PZero/Metronomus--Take-Your-Time/hardware/schema.md

# Schema elettrico

Schema elettrico

File: [schema.pdf](schema.pdf) (A3, vettoriale) · [schema.svg](schema.svg) · generato da [schema.py](schema.py) con `python hardware/schema.py`.

Le etichette uguali indicano piedini collegati tra loro. Gli stessi nomi di rete si usano nel piano fili.

## Reti

| Rete | Collega | Note |
|---|---|---|
| **VBAT** | TP4056 B+/OUT+ ↔ + delle due 18350 → source Q2, R8, LDO IN | Sempre presente, 3,0–4,2 V |
| **VSW** | drain Q2 → MT3608 VIN+, R1, modulo vibrazione VCC | Batteria dopo l'interruttore elettronico: spenta in letargo |
| PWR_EN | ESP32 GPIO4 → R3 10 kΩ → base Q3 2N3904 (R4 100 kΩ a GND) | Il collettore di Q3 tira giù il gate di Q2 (R8 100 kΩ verso VBAT) |
| **V12** | MT3608 VOUT+ → SimpleFOC +, Mini‑360 IN+, R6, R7 | 12,0 V |
| **3V3** | LDO OUT → ESP32 3V3 | Sempre acceso (anche in letargo) |
| **3V3_SW** | Mini‑360 OUT+ → AS5600 VCC | Spento in letargo |
| DRV_3V3 | SimpleFOC 3V3 → R9 10 kΩ → STOP | Pull‑up dell'EN, al posto del ponticello |
| STOP | SimpleFOC EN, paletti dei finecorsa, ESP32 GPIO43 | Basso = driver spento |
| ARMA | ESP32 GPIO44 → collare di ottone sul pendolo (filo flessibile) | 0 = stop attivo; 1 solo per staccarsi dal finecorsa all'avvio |
| **GND** | tutte le masse, AS5600 DIR, encoder C e SW | Comune |
| PWM_A / PWM_B / PWM_C | ESP32 GPIO7 / 6 / 5 → SimpleFOC IN1 / IN2 / IN3 | |
| SDA / SCL | ESP32 GPIO2 / 1 ↔ AS5600 SDA / SCL | I2C 400 kHz |
| ENC_A / ENC_B / ENC_SW | EC11 A / B / SW → ESP32 GPIO12 / 13 / 8 | Pull‑up interne, antirimbalzo nel firmware (niente RC, decisione del 18/10). GPIO8 risveglia dal deep sleep |
| LED_PWM | ESP32 GPIO10 → R5 470 Ω → base Q1 2N3904 (R10 100 kΩ a GND) | Corrente di base ≈ 5 mA: Q1 saturo fino a ~100 mA |
| LED_K | catodi LED1, LED2 → collettore Q1 | Emettitore di Q1 a GND |
| VIB_IN | ESP32 GPIO3 → modulo vibrazione IN | |
| VBAT_ADC | nodo R1/R2/C1 → ESP32 GPIO9 | Metà di VSW |
| M1 / M2 / M3 | SimpleFOC → fili del motore 1503 | L'ordine si aggiusta in firmware |

## Condensatori aggiuntivi (ruolo elettronica, 18/10)
- 220–470 µF tra V12 e GND direttamente ai morsetti PWR+/PWR− del driver.
- 100 nF tra 3V3_SW e GND sui pin dell'AS5600 (il Mini‑360 è uno switching).

## Da verificare sul banco
- Resistenze R6/R7 dei filamenti dopo la misura della Vf.
- Se il modulo AS5600 ha già le pull‑up su SDA/SCL (altrimenti 4,7 kΩ a 3V3).
- Modulo vibrazione: dalla foto ha già 5,1 kΩ tra base e GND, quindi niente pull‑down esterna (conferma col tester).

## Stop di emergenza
Vedi [pinout.md](pinout.md#stop-di-emergenza): paletti di rame a ±35° (STOP) e collare sul pendolo (ARMA); il contatto spegne il driver in hardware.

## Letargo (al posto dell'interruttore)
- Pressione di 3 s sul pulsante dell'encoder: il firmware ferma il pendolo, porta PWR_EN a 0 (Q2 spegne boost, driver, LED, AS5600 e vibrazione), mette SDA/SCL in alta impedenza e manda l'ESP32 in deep sleep con risveglio su GPIO8 basso.
- Al risveglio il firmware controlla che il pulsante resti premuto per 3 s; se viene lasciato prima, torna a dormire.
- Restano alimentati solo l'LDO e l'ESP32: consumo atteso di qualche decina di µA (da misurare). Togliere il LED rosso di alimentazione della SuperMini.
- Sull'ESP32‑S3 tutti i GPIO RTC (0–21) svegliano dal deep sleep: il pulsante è su GPIO8.
