PZero/Metronomus--Take-Your-Time/fili/misure-da-prendere.md

# Misure da prendere col calibro

Le posizioni dei fori dei moduli sono la base di tutto il rame: un errore di 0,5 mm su un pin si ritrova su ogni pezzo collegato. Oggi i valori in [`moduli.yaml`](moduli.yaml) sono **stimati** dalle foto; il PDF di taglio non si genera finché restano stimati.

## Come misurare
1. Metti la scheda **lato componenti in su**, orientata come scritto in `vista` per quel modulo.
2. L'origine è l'**angolo in basso a sinistra** della scheda. x verso destra, y verso l'alto.
3. Per ogni foro misura con il becco del calibro **dal bordo al bordo del foro** e aggiungi metà diametro del foro, così ottieni il centro. In alternativa infila un filo da 1 mm e misura al filo.
4. Per le file di pin a passo 2,54: misura solo il **primo** foro e controlla primo-ultimo (es. 9 pin: 20,32 mm).
5. Scrivi i numeri nella tabella qui sotto (o direttamente in `moduli.yaml`, cambiando `stato` in `misurato`).

## Tabella

| Modulo | Cosa misurare | Valore stimato (mm) | Misurato (mm) |
|---|---|---|---|
| ESP32‑S3 SuperMini | larghezza × altezza scheda | 18,00 × 23,50 (disegno Nologo; 18,00 già misurato) | |
| | **spessore del PCB** (non pubblicato) | 1,0 | |
| | primo foro fila sinistra (TX): x, y | 1,38 · 21,91 (disegno) | |
| | primo foro fila destra (5V): x, y | 16,62 · 21,91 (disegno) | |
| | sporgenza della USB‑C oltre il bordo | 1,2–2,2 (fonti divergenti) | |
| SimpleFOC Mini | ✅ dal disegno quotato: 26 × 21,5, fori Ø2 a 22 × 17,5, EN 5,08·20,2, nFT 5,08·17,66, M1 8,33·1,22, morsetti 22,75·15,52 / 22,75·10,32 | — | solo da confermare: ordine M1‑M3 e quale morsetto è + |
| MT3608 | larghezza × altezza | 36,0 × 17,0 | |
| | VIN−, VIN+, VOUT−, VOUT+: x, y | 3,0·13,0 · 3,0·4,5 · 33,2·12,1 · 33,2·4,8 | |
| | altezza del trimmer | 10,0 | |
| Mini‑360 | larghezza × altezza | 17,2 × 11,2 | |
| | IN+, IN−, OUT+, OUT−: x, y (e quale angolo è quale) | 1,3·9,9 · 1,3·1,3 · 15,9·9,9 · 15,9·1,3 | |
| AS5600 | larghezza × altezza | 23,5 × 23,3 | |
| | foro VCC: x, y · foro DIR: x, y | 4,85·14,3 · 18,2·16,6 | |
| | centro del chip: x, y | 11,6 · 11,9 | |
| TP4056 | larghezza × altezza (solo PCB) · sporgenza USB‑C | 26,1 × 17,4 · 1,8 (foto del venditore, micro‑USB) | |
| | OUT−, B−, B+, OUT+: x, y | 1,4·16,0 · 1,4·12,1 · 1,4·5,3 · 1,4·1,4 | |
| | IN−, IN+: x, y | 24,7·16,0 · 24,7·1,4 | |
| Motore 1503 | diametro campana · lunghezza base‑campana · interasse fori M2 | 19 · 15 · ? | |
| | **quanto sporge l'albero dal retro della base** (lì va il magnete Ø6 × 2,5, a 0,5–3 mm dal chip dell'AS5600) | 0 (a filo) | |
| Filo di rame | diametro reale (spesso è 0,95–1,05) | 1,00 | |

## Col tester (moduli scollegati)
- AS5600: resistenza **SDA–VCC**, **SCL–VCC** (pull‑up), **DIR–GND** (se c'è una resistenza, DIR non va collegato).
- Modulo vibrazione: resistenza **IN–GND** (atteso circa 6 kΩ: 1 kΩ + 5,1 kΩ).
- Filamento LED: tensione a 20–30 mA (Vf). Con due filamenti in serie serve circa il doppio.
