PZero/Metronomus--Take-Your-Time/fili/prove-giunti.md

# Prove di taglio e di giunto

Il circuito è fatto di **segmenti dritti saldati ad angolo retto**, senza pieghe. La precisione dipende da due cose: la lunghezza del taglio e la squadra del giunto. Questa prova si fa una volta, con lo stesso filo e gli stessi attrezzi della produzione.

## 1. Taglio a misura
- Il tronchesino lascia una punta a cuneo: per i giunti in battuta serve una **testa piana**.
- Metodo consigliato: tagliare ~0,3 mm più lungo, poi limare in squadra con una **battuta di fine corsa** (un blocchetto con foro da 1 mm e un fermo regolabile, anche inciso al laser).
- Controllo: calibro su 5 spezzoni da 50,0 mm. Obiettivo ±0,1 mm.

## 2. Giunto a L e a T
1. Raddrizza il filo in trazione e pulisci il rame (lana d'acciaio fine o alcool).
2. Pre‑stagna la testa del segmento in battuta e il punto del passante.
3. Blocca i due pezzi nella dima a 90°, con la testa appoggiata al fianco.
4. Salda con poco stagno: deve formare un piccolo raccordo, non una goccia.
5. Misura con il calibro le quote esterne del giunto e confrontale con il disegno.

## 3. Risultati

| Data | Prova | Errore medio (mm) | Note |
|---|---|---|---|
| — | taglio 50 mm | — | da fare |
| — | giunto a L | — | da fare |
| — | giunto a T | — | da fare |

Lo scostamento medio misurato al punto 2 diventa la correzione da applicare in `fili/geometria.yaml`.
