PZero/Metronomus--Take-Your-Time/foto/boost-mt3608.jpg

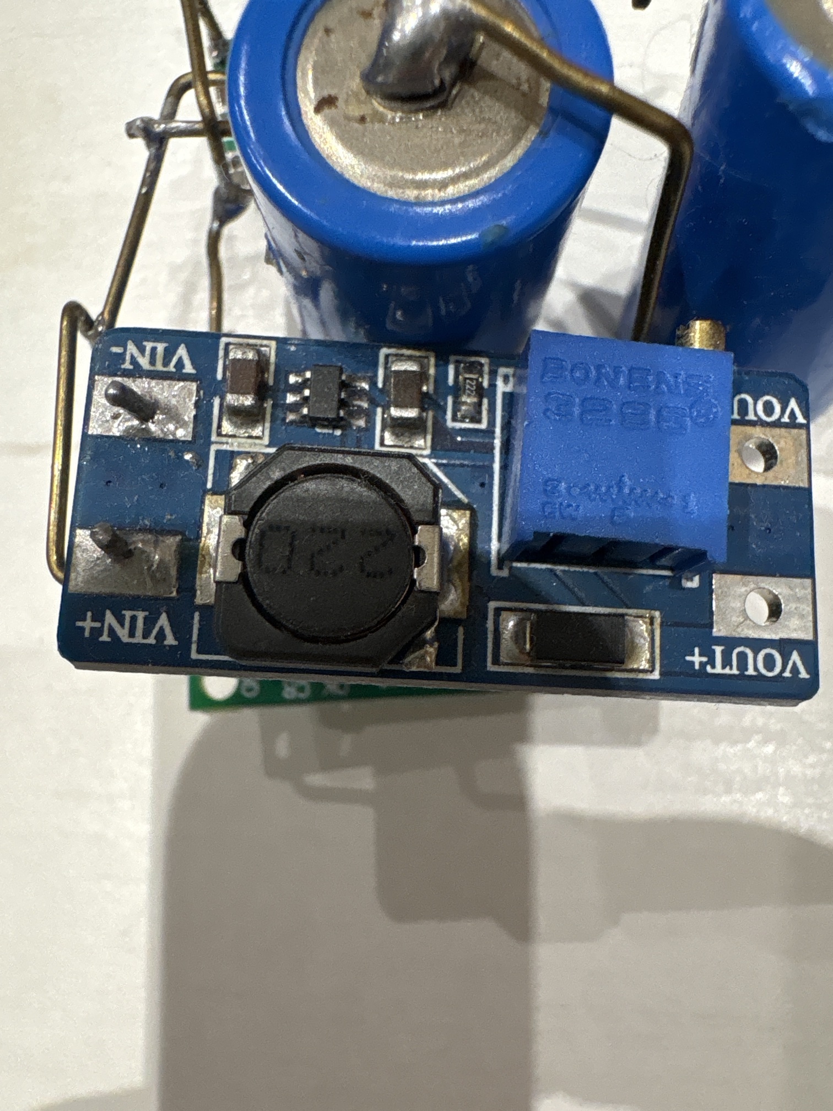
foto/boost-mt3608.jpg
