PZero/Metronomus--Take-Your-Time/foto/caricatore-tp4056-usbc.jpg

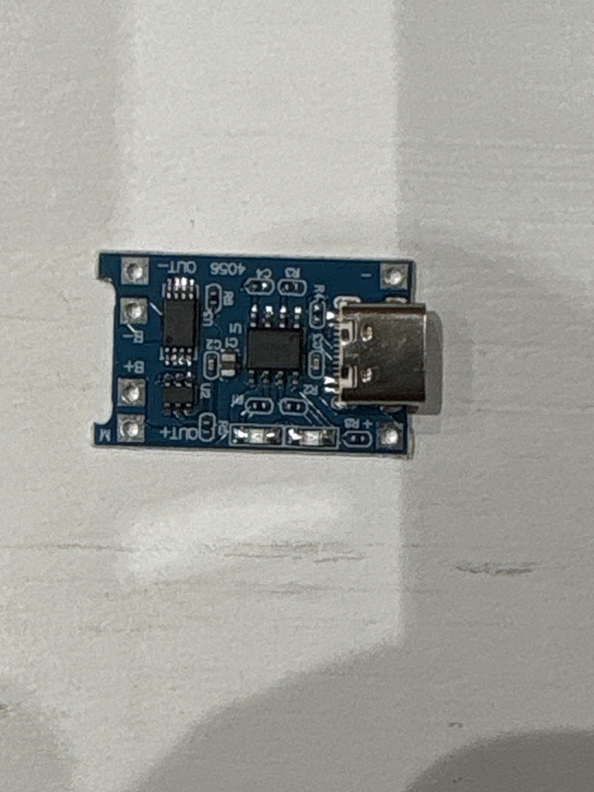
foto/caricatore-tp4056-usbc.jpg
