PZero/Metronomus--Take-Your-Time/foto/driver-simplefoc-mini.jpg

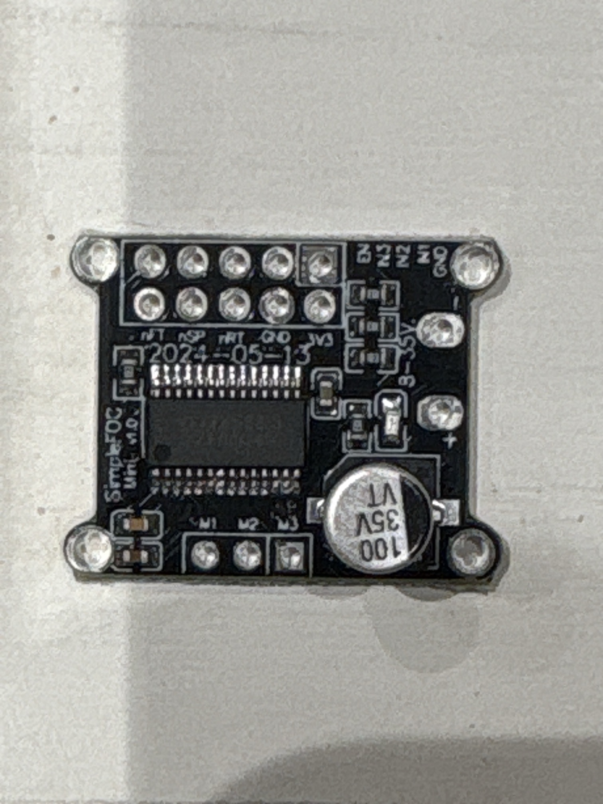
foto/driver-simplefoc-mini.jpg
