PZero/Metronomus--Take-Your-Time/foto/encoder-ec11.jpg

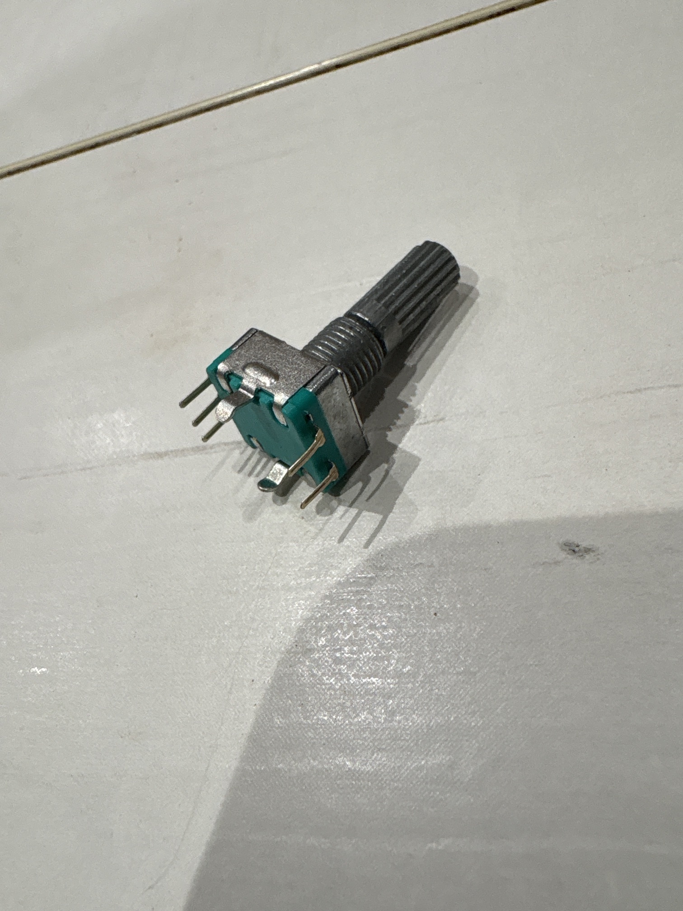
foto/encoder-ec11.jpg
