PZero/Metronomus--Take-Your-Time/foto/esp32-d1-mini-wroom.jpg

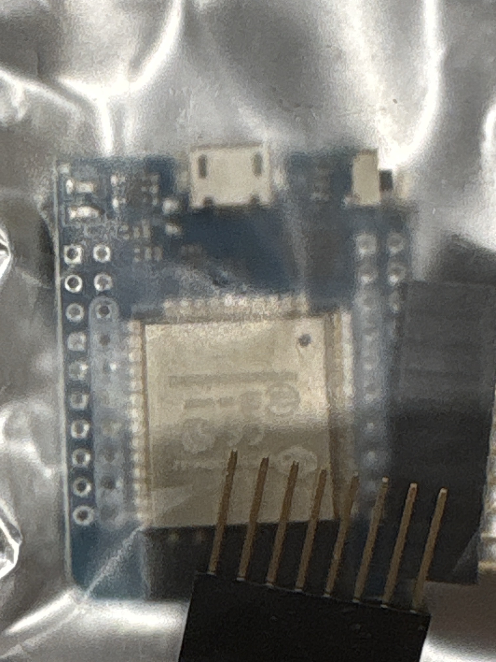
foto/esp32-d1-mini-wroom.jpg
