PZero/Metronomus--Take-Your-Time/foto/esp32-s3-supermini.jpg

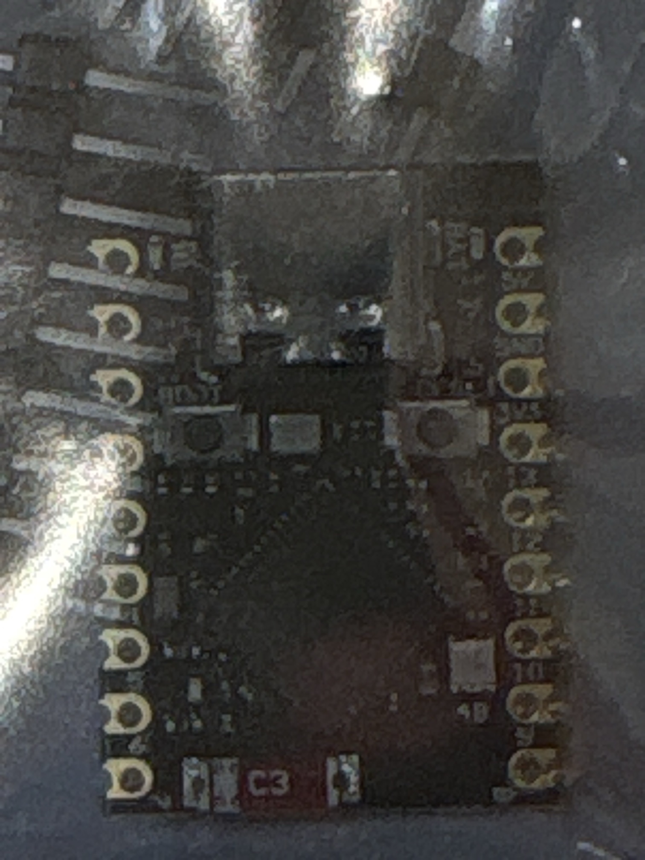
foto/esp32-s3-supermini.jpg
