PZero/Metronomus--Take-Your-Time/foto/led-filamento-prova.jpg

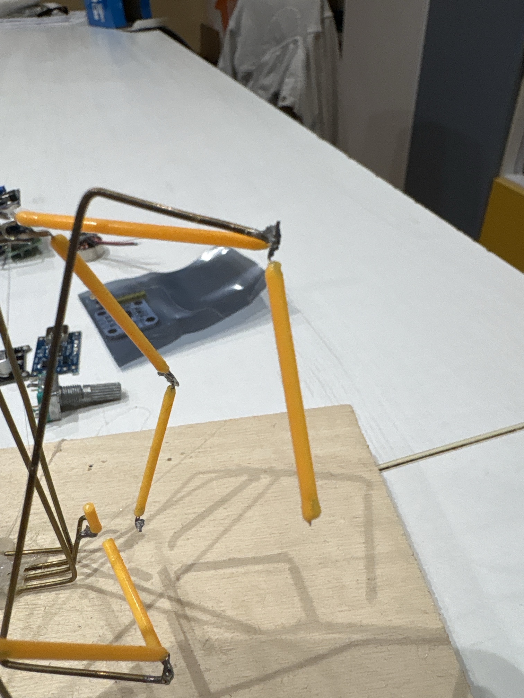
foto/led-filamento-prova.jpg
