PZero/Metronomus--Take-Your-Time/foto/motore-1503.jpg

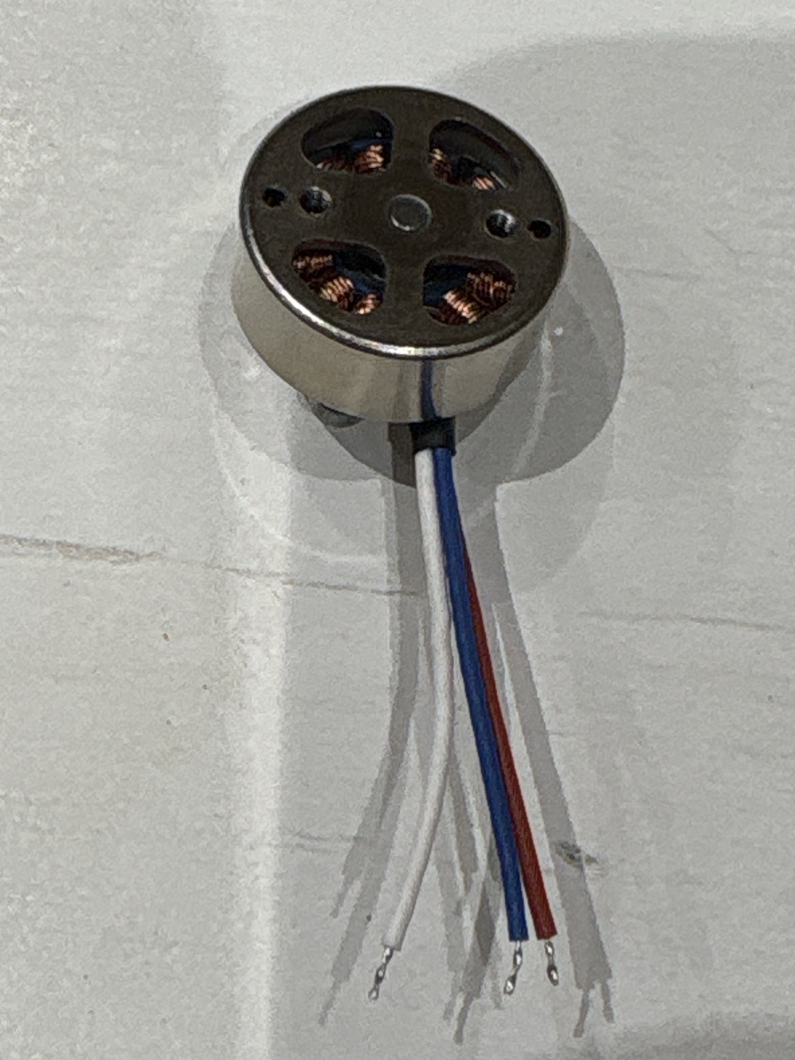
foto/motore-1503.jpg
