PZero/Metronomus--Take-Your-Time/foto/sensore-as5600.jpg

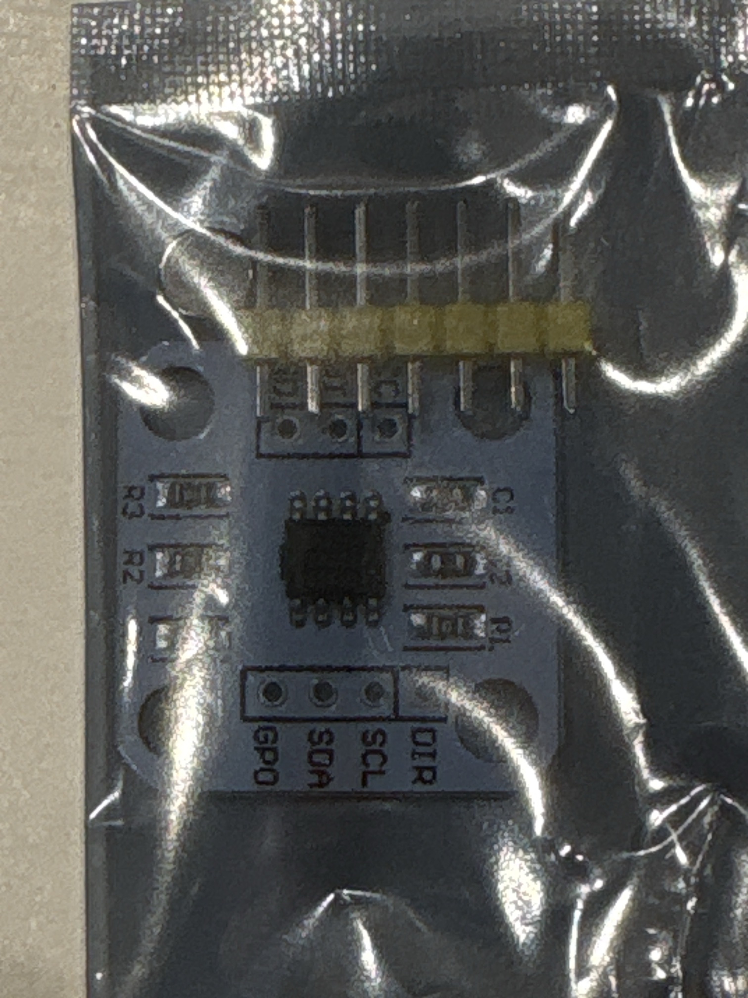
foto/sensore-as5600.jpg
