PZero/Metronomus--Take-Your-Time/foto/stepdown-mini360.jpg

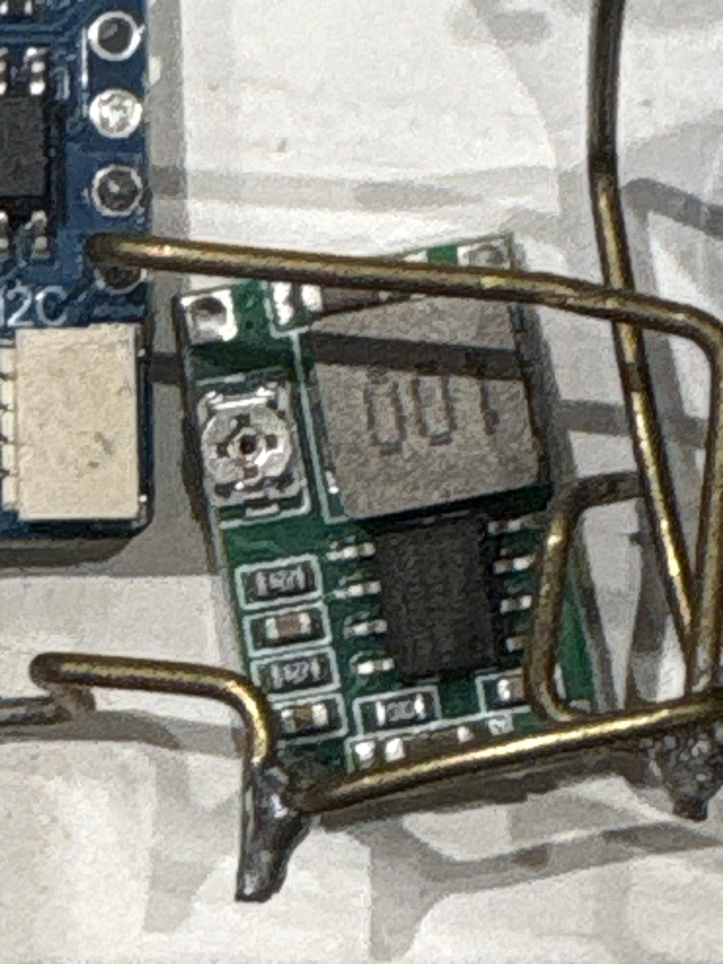
foto/stepdown-mini360.jpg
