PZero/Metronomus--Take-Your-Time/modello/anteprima.png

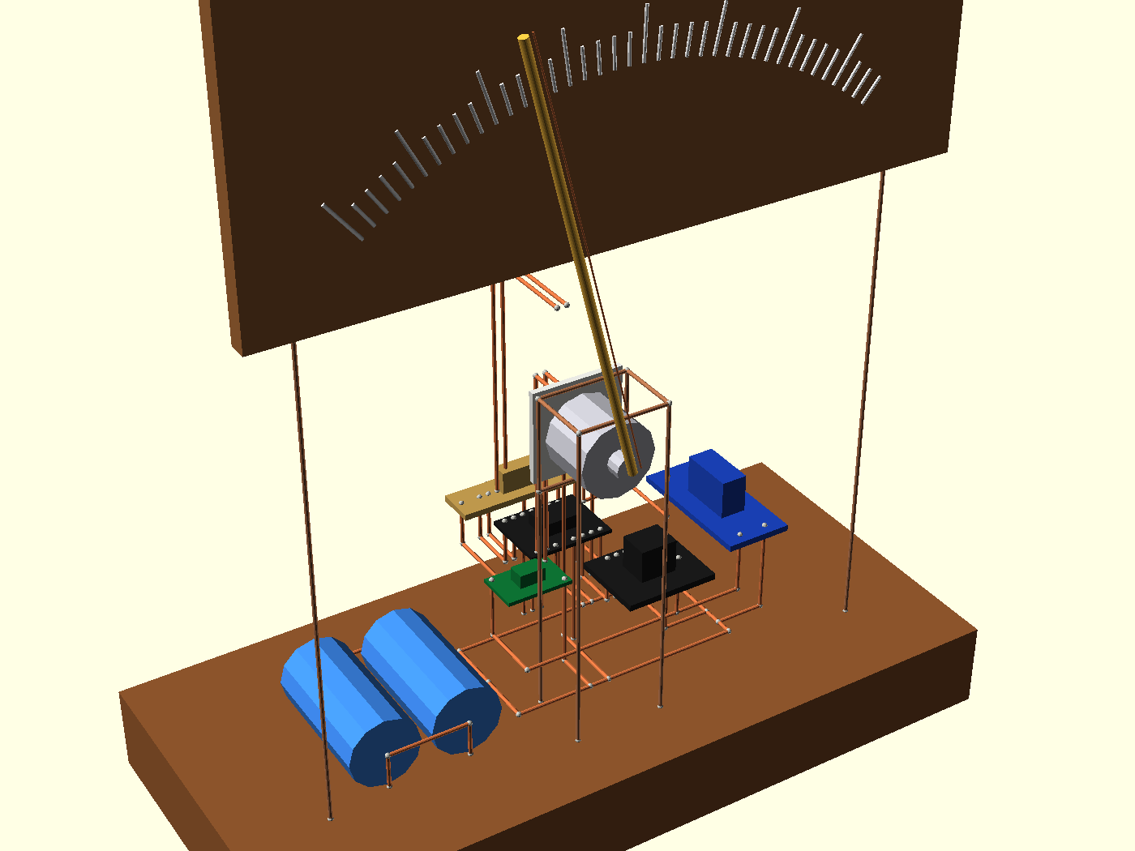
modello/anteprima.png
