PZero/Metronomus--Take-Your-Time/modello/criticita.png

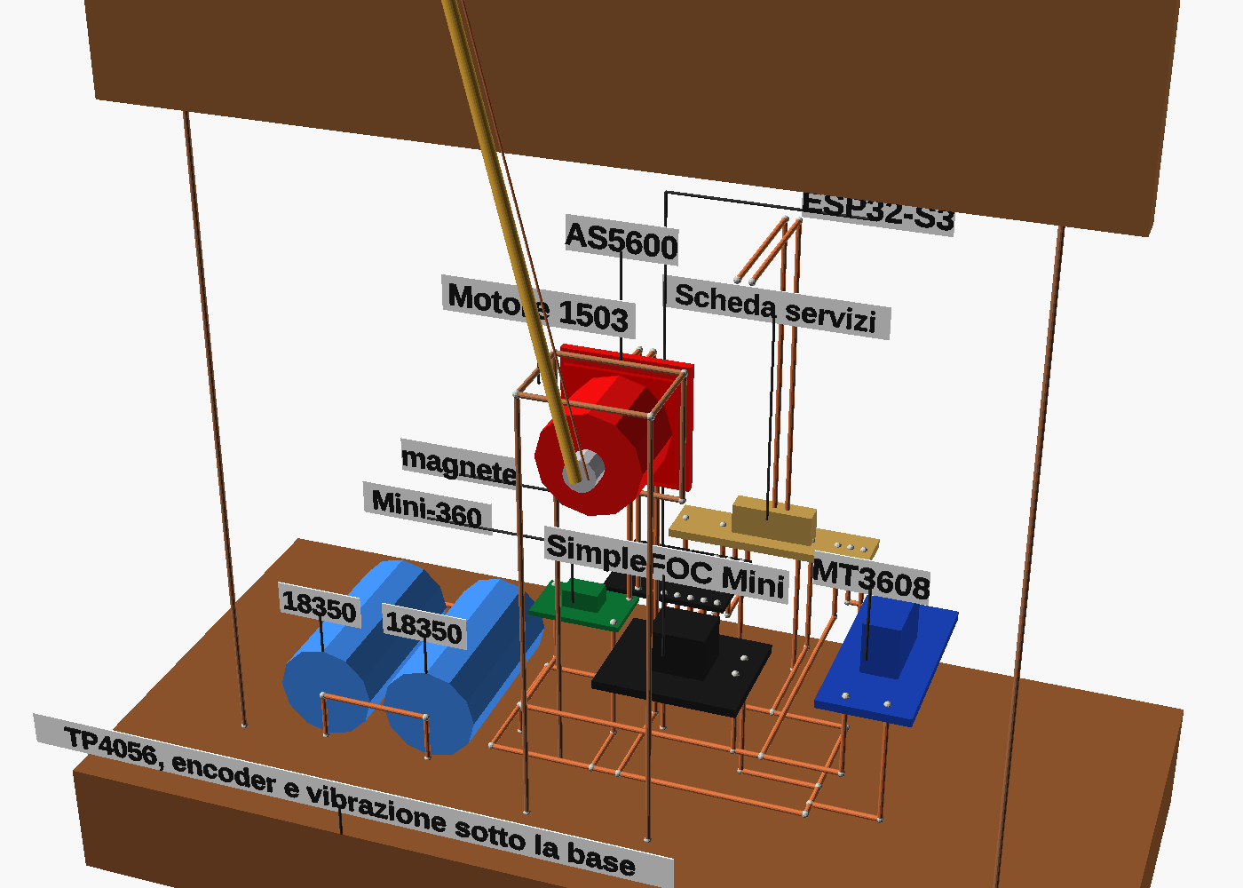
modello/criticita.png
