PZero/Metronomus--Take-Your-Time/render/concept.png

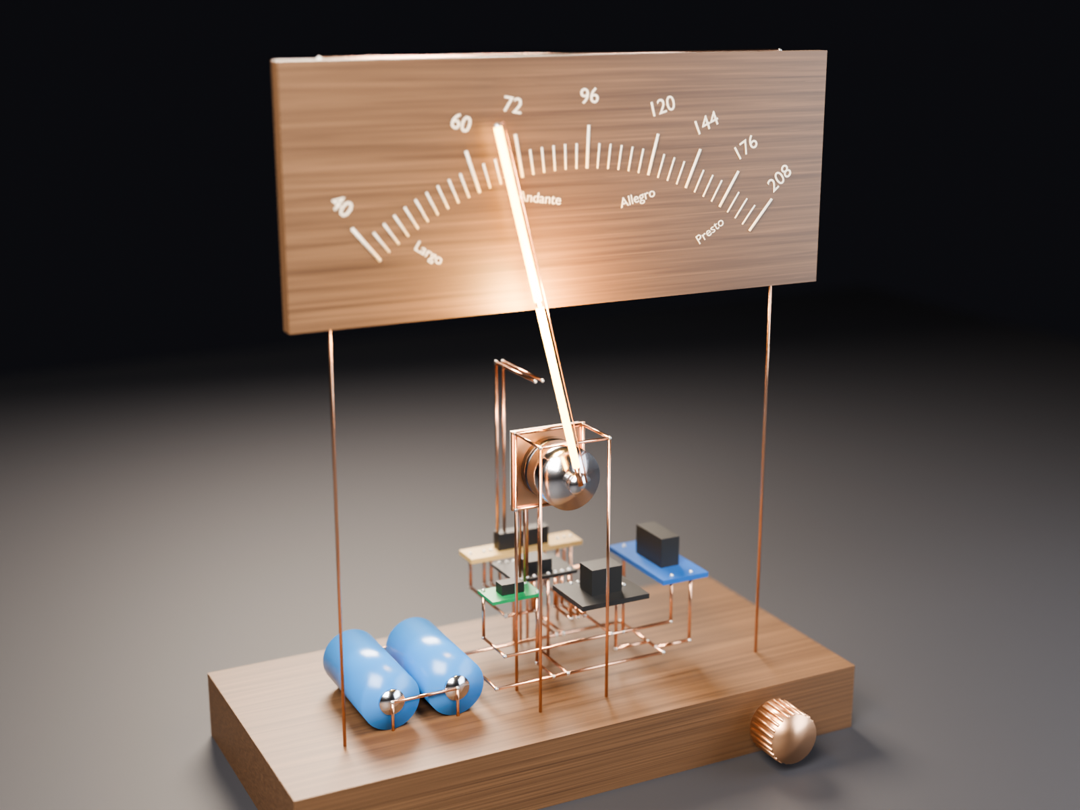
render/concept.png
