PZero/Metronomus--Take-Your-Time/modello/metronomus.scad

// Metronomus: modello 3D di controllo, GENERATO da fili/geometria.py: non modificarlo a mano.
// Misure dei moduli in fili/moduli.yaml. Assi in mm, z = 0 piano della base.

/* [Vista] */
teca = true;
mostra_vetro = true;
mostra_scala = true;
angolo_pendolo = -14;
// criticità (errori dei controlli) in rosso, con le zone di contatto evidenziate
criticita = true;
// nomi delle schede e dei componenti, su cartellini rivolti verso il fronte
etichette = true;

// nessuna criticità

$fn = 24;
R = 0.50;

module seg(a, b, r = R) { v = b - a; l = norm(v);
    if (l > 0) translate(a) rotate([0, acos(v[2] / l), atan2(v[1], v[0])]) cylinder(r = r, h = l, $fn = 12); }
module etichetta(punto, testo, alto, dx = 0) {  // cartellino rivolto verso il fronte (-y): filo guida su di alto, poi di lato di dx
    color([0.2, 0.2, 0.2]) { seg(punto, punto + [0, 0, alto], 0.25); seg(punto + [0, 0, alto], punto + [dx, 0, alto], 0.25); }
    translate(punto + [dx, 0, alto]) rotate([90, 0, 0]) {
        color("white") translate([-len(testo) * 1.45 - 1, -1.2, -0.3]) cube([len(testo) * 2.9 + 2, 6.4, 0.3]);
        color([0.1, 0.1, 0.1]) linear_extrude(0.4) text(testo, size = 4, halign = "center", font = "Liberation Sans:style=Bold");
    } }
module scheda(o, u, v, n, d, sp, alt, col) {
    color(col) multmatrix([[u[0], v[0], n[0], o[0]], [u[1], v[1], n[1], o[1]], [u[2], v[2], n[2], o[2]], [0, 0, 0, 1]]) {
        translate([0, 0, -sp]) cube([d[0], d[1], sp]);
        color([0.15, 0.15, 0.15]) translate([d[0] * 0.3, d[1] * 0.3, 0]) cube([d[0] * 0.4, d[1] * 0.4, alt]);
    } }

color([0.55, 0.33, 0.17]) translate([-75.0, -22.0, -22.0]) cube([150.0, 90.0, 22.0]);
if (teca && mostra_vetro) color([0.8, 0.95, 1.0, 0.15]) translate([-70.0, -17.0, 0]) difference() { cube([140.0, 80.0, 220]); translate([3, 3, -1]) cube([134.0, 74.0, 218]); }
scheda([11.25, 13.8, 60.75], [0, 0, 1], [-1, 0, 0], [0, -1, 0], [22.5, 22.5], 1.6, 1.8, [0.92, 0.92, 0.9]);  // AS5600
scheda([13.73, 24.0, 30.0], [0, 1, 0], [-1, 0, 0], [0, 0, 1], [18.0, 24.0], 3.0, 3.2, [0.1, 0.1, 0.1]);  // ESP32-S3
scheda([-0.16999999999999993, -6.199999999999999, 30.0], [1, 0, 0], [0, 1, 0], [0, 0, 1], [26.0, 21.5], 1.6, 8.0, [0.1, 0.1, 0.1]);  // SimpleFOC Mini
scheda([-19.33, 10.0, 30.0], [1, 0, 0], [0, 1, 0], [0, 0, 1], [18.0, 12.0], 1.0, 3.5, [0.05, 0.45, 0.2]);  // Mini-360
scheda([38.8, 39.12, 30.0], [0, -1, 0], [1, 0, 0], [0, 0, 1], [37.5, 18.0], 1.6, 4.9, [0.1, 0.25, 0.7]);  // MT3608
scheda([-9.06, 44.37, 30.0], [1, 0, 0], [0, 1, 0], [0, 0, 1], [43.18, 15.24], 1.6, 9.0, [0.75, 0.6, 0.3]);  // Scheda servizi
scheda([1.1, 17.92, 1.3], [1, 0, 0], [0, 1, 0], [0, 0, 1], [15.0, 10.0], 1.0, 3.0, [0.1, 0.1, 0.1]);  // Vibrazione
color([0.75, 0.75, 0.78]) seg([0.0, 9.0, 72.0], [0.0, -6.0, 72.0], 9.5);
color([0.35, 0.35, 0.4]) seg([0.0, 9.0, 72.0], [0.0, 11.0, 72.0], 3.0);  // magnete dell'AS5600
color([0.75, 0.75, 0.78]) seg([0.0, -6.0, 72.0], [0.0, -10.0, 72.0], 3);
translate([0.0, -11.5, 72.0]) rotate([0, angolo_pendolo, 0]) { color([1, 0.75, 0.25]) cylinder(r = 1.1, h = 108); color([0.85, 0.45, 0.25]) translate([2.2, 0, 0]) cylinder(r = 0.2, h = 108); color([0.8, 0.65, 0.3]) translate([0, 0, 24.9]) cylinder(r = 3.0, h = 10); }  // collare ARMA
color([0.25, 0.55, 0.95]) seg([-35.0, 2.0, 9.0], [-35.0, 37.0, 9.0], 9.0);
color([0.25, 0.55, 0.95]) seg([-56.0, 2.0, 9.0], [-56.0, 37.0, 9.0], 9.0);
color([0.6, 0.38, 0.2]) translate([-62.0, -7.5, 125.0]) cube([124, 5.0, 70.0]);
if (mostra_scala) for (i = [0 : 38]) { t = -30.0 + 60.0 * i / 38; l = (i % 5 == 0) ? 104.0 : 99.0;
    color("white") seg([0.0 + 92.0 * sin(t), -7.6, 72.0 + 92.0 * cos(t)], [0.0 + l * sin(t), -7.6, 72.0 + l * cos(t)], 0.4); }
color([0.85, 0.45, 0.25]) seg([-22.0, 0.0, 6.0], [37.5, 0.0, 6.0]);  // GND-01
color([0.85, 0.45, 0.25]) seg([37.5, 0.0, 6.0], [37.5, 29.5, 6.0]);  // GND-02
color([0.85, 0.45, 0.25]) seg([37.5, 29.5, 6.0], [-22.0, 29.5, 6.0]);  // GND-03
color([0.85, 0.45, 0.25]) seg([-22.0, 29.5, 6.0], [-22.0, 0.0, 6.0]);  // GND-04
color([0.85, 0.45, 0.25]) seg([37.5, 6.72, 6.0], [37.5, 6.72, 0.0]);  // GND-05
color([0.85, 0.45, 0.25]) seg([52.8, 4.12, 30.0], [52.8, 4.12, 6.0]);  // GND-06
color([0.85, 0.45, 0.25]) seg([52.8, 4.12, 6.0], [37.5, 4.12, 6.0]);  // GND-07
color([0.85, 0.45, 0.25]) seg([-2.83, 11.0, 30.0], [-2.83, 11.0, 6.0]);  // GND-08
color([0.85, 0.45, 0.25]) seg([-2.83, 11.0, 6.0], [-2.83, 0.0, 6.0]);  // GND-09
color([0.85, 0.45, 0.25]) seg([22.69, 53.26, 30.0], [22.69, 53.26, 6.0]);  // GND-10
color([0.85, 0.45, 0.25]) seg([22.69, 53.26, 6.0], [22.69, 29.5, 6.0]);  // GND-11
color([0.85, 0.45, 0.25]) seg([-5.25, 41.0, 30.0], [-5.25, 41.0, 6.0]);  // GND-12
color([0.85, 0.45, 0.25]) seg([-5.25, 41.0, 6.0], [-5.25, 29.5, 6.0]);  // GND-13
color([0.85, 0.45, 0.25]) seg([2.37, 19.92, 1.3], [2.37, 19.92, 0.0]);  // GND-14
color([0.85, 0.45, 0.25]) seg([22.58, 9.32, 30.0], [22.58, 9.32, 6.0]);  // GND-15
color([0.85, 0.45, 0.25]) seg([22.58, 9.32, 6.0], [37.5, 9.32, 6.0]);  // GND-16
color([0.85, 0.45, 0.25]) seg([2.25, 13.8, 65.75], [2.25, 21.0, 65.75]);  // GND-17
color([0.85, 0.45, 0.25]) seg([2.25, 21.0, 65.75], [2.25, 21.0, 6.0]);  // GND-18
color([0.85, 0.45, 0.25]) seg([2.25, 21.0, 6.0], [2.25, 0.0, 6.0]);  // GND-19
color([0.85, 0.45, 0.25]) seg([45.8, 4.12, 14.0], [-17.83, 4.12, 14.0]);  // V12-01
color([0.85, 0.45, 0.25]) seg([-17.83, 4.12, 14.0], [-17.83, 24.0, 14.0]);  // V12-02
color([0.85, 0.45, 0.25]) seg([27.77, 4.12, 14.0], [27.77, 56.26, 14.0]);  // V12-03
color([0.85, 0.45, 0.25]) seg([42.8, 4.12, 30.0], [42.8, 4.12, 14.0]);  // V12-04
color([0.85, 0.45, 0.25]) seg([-17.83, 21.0, 30.0], [-17.83, 21.0, 14.0]);  // V12-05
color([0.85, 0.45, 0.25]) seg([27.77, 53.26, 30.0], [27.77, 53.26, 14.0]);  // V12-06
color([0.85, 0.45, 0.25]) seg([22.58, 4.12, 30.0], [22.58, 4.12, 14.0]);  // V12-07
color([0.85, 0.45, 0.25]) seg([12.53, 11.0, 18.0], [12.53, 28.0, 18.0]);  // PWM_A-01
color([0.85, 0.45, 0.25]) seg([12.53, 25.0, 30.0], [12.53, 25.0, 18.0]);  // PWM_A-02
color([0.85, 0.45, 0.25]) seg([12.53, 14.0, 30.0], [12.53, 14.0, 18.0]);  // PWM_A-03
color([0.85, 0.45, 0.25]) seg([9.99, 11.0, 18.0], [9.99, 28.0, 18.0]);  // PWM_B-01
color([0.85, 0.45, 0.25]) seg([9.99, 25.0, 30.0], [9.99, 25.0, 18.0]);  // PWM_B-02
color([0.85, 0.45, 0.25]) seg([9.99, 14.0, 30.0], [9.99, 14.0, 18.0]);  // PWM_B-03
color([0.85, 0.45, 0.25]) seg([7.45, 11.0, 18.0], [7.45, 28.0, 18.0]);  // PWM_C-01
color([0.85, 0.45, 0.25]) seg([7.45, 25.0, 30.0], [7.45, 25.0, 18.0]);  // PWM_C-02
color([0.85, 0.45, 0.25]) seg([7.45, 14.0, 30.0], [7.45, 14.0, 18.0]);  // PWM_C-03
color([0.85, 0.45, 0.25]) seg([4.91, 22.0, 18.0], [4.91, 56.26, 18.0]);  // PWR_EN-01
color([0.85, 0.45, 0.25]) seg([4.91, 53.26, 30.0], [4.91, 53.26, 18.0]);  // PWR_EN-02
color([0.85, 0.45, 0.25]) seg([4.91, 25.0, 30.0], [4.91, 25.0, 18.0]);  // PWR_EN-03
color([0.85, 0.45, 0.25]) seg([-2.71, 38.0, 18.0], [-2.71, 56.26, 18.0]);  // 3V3-01
color([0.85, 0.45, 0.25]) seg([-2.71, 53.26, 30.0], [-2.71, 53.26, 18.0]);  // 3V3-02
color([0.85, 0.45, 0.25]) seg([-2.71, 41.0, 30.0], [-2.71, 41.0, 18.0]);  // 3V3-03
color([0.85, 0.45, 0.25]) seg([7.45, 38.0, 18.0], [7.45, 56.26, 18.0]);  // LED_PWM-01
color([0.85, 0.45, 0.25]) seg([7.45, 53.26, 30.0], [7.45, 53.26, 18.0]);  // LED_PWM-02
color([0.85, 0.45, 0.25]) seg([7.45, 41.0, 30.0], [7.45, 41.0, 18.0]);  // LED_PWM-03
color([0.85, 0.45, 0.25]) seg([9.99, 38.0, 18.0], [9.99, 56.26, 18.0]);  // VBAT_ADC-01
color([0.85, 0.45, 0.25]) seg([9.99, 53.26, 30.0], [9.99, 53.26, 18.0]);  // VBAT_ADC-02
color([0.85, 0.45, 0.25]) seg([9.99, 41.0, 30.0], [9.99, 41.0, 18.0]);  // VBAT_ADC-03
color([0.85, 0.45, 0.25]) seg([30.31, 56.26, 18.0], [30.31, 36.62, 18.0]);  // VSW-01
color([0.85, 0.45, 0.25]) seg([30.31, 36.62, 18.0], [45.8, 36.62, 18.0]);  // VSW-02
color([0.85, 0.45, 0.25]) seg([42.8, 36.62, 30.0], [42.8, 36.62, 18.0]);  // VSW-03
color([0.85, 0.45, 0.25]) seg([30.31, 53.26, 30.0], [30.31, 53.26, 18.0]);  // VSW-04
color([0.85, 0.45, 0.25]) seg([32.85, 53.26, 30.0], [32.85, 53.26, 0.0]);  // VSW-05
color([0.85, 0.45, 0.25]) seg([2.37, 22.46, 1.3], [2.37, 22.46, 0.0]);  // VSW-06
color([0.85, 0.45, 0.25]) seg([20.15, 53.26, 30.0], [20.15, 53.26, 0.0]);  // VBAT-01
color([0.85, 0.45, 0.25]) seg([17.61, 53.26, 30.0], [17.61, 53.26, 95.0]);  // LED_A-01
color([0.85, 0.45, 0.25]) seg([17.61, 53.26, 95.0], [17.61, -3.5, 95.0]);  // LED_A-02
color([0.85, 0.45, 0.25]) seg([15.07, 53.26, 30.0], [15.07, 53.26, 95.0]);  // LED_K-01
color([0.85, 0.45, 0.25]) seg([15.07, 53.26, 95.0], [15.07, -3.5, 95.0]);  // LED_K-02
color([0.85, 0.45, 0.25]) seg([2.37, 25.0, 30.0], [2.37, 25.0, 1.3]);  // VIB_IN-01
color([0.85, 0.45, 0.25]) seg([12.53, 41.0, 30.0], [12.53, 41.0, 0.0]);  // ENC_SW-01
color([0.85, 0.45, 0.25]) seg([2.37, 41.0, 30.0], [2.37, 41.0, 0.0]);  // ENC_A-01
color([0.85, 0.45, 0.25]) seg([-0.17, 41.0, 30.0], [-0.17, 41.0, 0.0]);  // ENC_B-01
color([0.85, 0.45, 0.25]) seg([-2.71, 13.8, 78.25], [-2.71, 25.0, 78.25]);  // SCL-01
color([0.85, 0.45, 0.25]) seg([-2.71, 25.0, 78.25], [-2.71, 25.0, 30.0]);  // SCL-02
color([0.85, 0.45, 0.25]) seg([-0.17, 13.8, 78.25], [-0.17, 25.0, 78.25]);  // SDA-01
color([0.85, 0.45, 0.25]) seg([-0.17, 25.0, 78.25], [-0.17, 25.0, 30.0]);  // SDA-02
color([0.85, 0.45, 0.25]) seg([-2.83, 13.8, 65.75], [-2.83, 21.0, 65.75]);  // 3V3_SW-01
color([0.85, 0.45, 0.25]) seg([-2.83, 21.0, 65.75], [-2.83, 21.0, 30.0]);  // 3V3_SW-02
color([0.85, 0.45, 0.25]) seg([-20.0, -11.5, 0.0], [-20.0, -11.5, 94.5]);  // STOP-01
color([0.85, 0.45, 0.25]) seg([20.0, -11.5, 0.0], [20.0, -11.5, 94.5]);  // STOP-02
color([0.85, 0.45, 0.25]) seg([-20.0, -11.5, 18.0], [20.0, -11.5, 18.0]);  // STOP-03
color([0.85, 0.45, 0.25]) seg([4.91, 17.0, 18.0], [4.91, -11.5, 18.0]);  // STOP-04
color([0.85, 0.45, 0.25]) seg([4.91, 14.0, 30.0], [4.91, 14.0, 18.0]);  // STOP-05
color([0.85, 0.45, 0.25]) seg([-7.79, 28.0, 18.0], [-7.79, -11.5, 18.0]);  // STOP-06
color([0.85, 0.45, 0.25]) seg([-7.79, 25.0, 30.0], [-7.79, 25.0, 18.0]);  // STOP-07
color([0.85, 0.45, 0.25]) seg([-5.25, 25.0, 30.0], [-5.25, 25.0, 95.0]);  // ARMA-01
color([0.85, 0.45, 0.25]) seg([-5.25, 25.0, 95.0], [-5.25, -3.5, 95.0]);  // ARMA-02
color([0.7, 0.45, 0.3]) seg([-11.5, 8.5, 0.0], [-11.5, 8.5, 84.0]);  // TELAIO-01
color([0.7, 0.45, 0.3]) seg([-11.5, -8.0, 0.0], [-11.5, -8.0, 84.0]);  // TELAIO-02
color([0.7, 0.45, 0.3]) seg([11.5, -8.0, 0.0], [11.5, -8.0, 84.0]);  // TELAIO-03
color([0.7, 0.45, 0.3]) seg([-11.5, 8.5, 84.0], [11.5, 8.5, 84.0]);  // TELAIO-04
color([0.7, 0.45, 0.3]) seg([11.5, 8.5, 84.0], [11.5, 8.5, 60.0]);  // TELAIO-05
color([0.7, 0.45, 0.3]) seg([11.5, 8.5, 60.0], [-11.5, 8.5, 60.0]);  // TELAIO-06
color([0.7, 0.45, 0.3]) seg([-11.5, 8.5, 84.0], [-11.5, -8.0, 84.0]);  // TELAIO-07
color([0.7, 0.45, 0.3]) seg([-11.5, -8.0, 84.0], [11.5, -8.0, 84.0]);  // TELAIO-08
color([0.7, 0.45, 0.3]) seg([11.5, -8.0, 84.0], [11.5, 8.5, 84.0]);  // TELAIO-09
color([0.7, 0.45, 0.3]) seg([-57.0, -1.5, 0.0], [-57.0, -1.5, 195.0]);  // PANNELLO-01
color([0.7, 0.45, 0.3]) seg([57.0, -1.5, 0.0], [57.0, -1.5, 195.0]);  // PANNELLO-02
color([0.7, 0.45, 0.3]) seg([-57.0, -1.5, 195.0], [57.0, -1.5, 195.0]);  // PANNELLO-03
color([0.85, 0.45, 0.25]) seg([-35.0, 1.5, 0.0], [-35.0, 1.5, 9.0]);  // BATT+-01
color([0.85, 0.45, 0.25]) seg([-35.0, 1.5, 9.0], [-56.0, 1.5, 9.0]);  // BATT+-02
color([0.85, 0.45, 0.25]) seg([-56.0, 1.5, 9.0], [-56.0, 1.5, 0.0]);  // BATT+-03
color([0.85, 0.45, 0.25]) seg([-35.0, 37.5, 0.0], [-35.0, 37.5, 9.0]);  // BATT--01
color([0.85, 0.45, 0.25]) seg([-35.0, 37.5, 9.0], [-56.0, 37.5, 9.0]);  // BATT--02
color([0.85, 0.45, 0.25]) seg([-56.0, 37.5, 9.0], [-56.0, 37.5, 0.0]);  // BATT--03
color([0.75, 0.75, 0.72]) for (g = [[-57.0, -1.5, 0.0], [-57.0, -1.5, 195.0], [-56.0, 1.5, 0.0], [-56.0, 1.5, 9.0], [-56.0, 37.5, 0.0], [-56.0, 37.5, 9.0], [-35.0, 1.5, 0.0], [-35.0, 1.5, 9.0], [-35.0, 37.5, 0.0], [-35.0, 37.5, 9.0], [-22.0, 0.0, 6.0], [-22.0, 29.5, 6.0], [-20.0, -11.5, 0.0], [-20.0, -11.5, 18.0], [-20.0, -11.5, 94.5], [-17.83, 4.12, 14.0], [-17.83, 21.0, 14.0], [-17.83, 21.0, 30.0], [-17.83, 24.0, 14.0], [-11.5, -8.0, 0.0], [-11.5, -8.0, 84.0], [-11.5, 8.5, 0.0], [-11.5, 8.5, 60.0], [-11.5, 8.5, 84.0], [-7.79, -11.5, 18.0], [-7.79, 25.0, 18.0], [-7.79, 25.0, 30.0], [-7.79, 28.0, 18.0], [-5.25, -3.5, 95.0], [-5.25, 25.0, 30.0], [-5.25, 25.0, 95.0], [-5.25, 29.5, 6.0], [-5.25, 41.0, 6.0], [-5.25, 41.0, 30.0], [-2.83, 0.0, 6.0], [-2.83, 11.0, 6.0], [-2.83, 11.0, 30.0], [-2.83, 13.8, 65.75], [-2.83, 21.0, 30.0], [-2.83, 21.0, 65.75], [-2.71, 13.8, 78.25], [-2.71, 25.0, 30.0], [-2.71, 25.0, 78.25], [-2.71, 38.0, 18.0], [-2.71, 41.0, 18.0], [-2.71, 41.0, 30.0], [-2.71, 53.26, 18.0], [-2.71, 53.26, 30.0], [-2.71, 56.26, 18.0], [-0.17, 13.8, 78.25], [-0.17, 25.0, 30.0], [-0.17, 25.0, 78.25], [-0.17, 41.0, 0.0], [-0.17, 41.0, 30.0], [2.25, 0.0, 6.0], [2.25, 13.8, 65.75], [2.25, 21.0, 6.0], [2.25, 21.0, 65.75], [2.37, 19.92, 0.0], [2.37, 19.92, 1.3], [2.37, 22.46, 0.0], [2.37, 22.46, 1.3], [2.37, 25.0, 1.3], [2.37, 25.0, 30.0], [2.37, 41.0, 0.0], [2.37, 41.0, 30.0], [4.91, -11.5, 18.0], [4.91, 14.0, 18.0], [4.91, 14.0, 30.0], [4.91, 17.0, 18.0], [4.91, 22.0, 18.0], [4.91, 25.0, 18.0], [4.91, 25.0, 30.0], [4.91, 53.26, 18.0], [4.91, 53.26, 30.0], [4.91, 56.26, 18.0], [7.45, 11.0, 18.0], [7.45, 14.0, 18.0], [7.45, 14.0, 30.0], [7.45, 25.0, 18.0], [7.45, 25.0, 30.0], [7.45, 28.0, 18.0], [7.45, 38.0, 18.0], [7.45, 41.0, 18.0], [7.45, 41.0, 30.0], [7.45, 53.26, 18.0], [7.45, 53.26, 30.0], [7.45, 56.26, 18.0], [9.99, 11.0, 18.0], [9.99, 14.0, 18.0], [9.99, 14.0, 30.0], [9.99, 25.0, 18.0], [9.99, 25.0, 30.0], [9.99, 28.0, 18.0], [9.99, 38.0, 18.0], [9.99, 41.0, 18.0], [9.99, 41.0, 30.0], [9.99, 53.26, 18.0], [9.99, 53.26, 30.0], [9.99, 56.26, 18.0], [11.5, -8.0, 0.0], [11.5, -8.0, 84.0], [11.5, 8.5, 60.0], [11.5, 8.5, 84.0], [12.53, 11.0, 18.0], [12.53, 14.0, 18.0], [12.53, 14.0, 30.0], [12.53, 25.0, 18.0], [12.53, 25.0, 30.0], [12.53, 28.0, 18.0], [12.53, 41.0, 0.0], [12.53, 41.0, 30.0], [15.07, -3.5, 95.0], [15.07, 53.26, 30.0], [15.07, 53.26, 95.0], [17.61, -3.5, 95.0], [17.61, 53.26, 30.0], [17.61, 53.26, 95.0], [20.0, -11.5, 0.0], [20.0, -11.5, 18.0], [20.0, -11.5, 94.5], [20.15, 53.26, 0.0], [20.15, 53.26, 30.0], [22.58, 4.12, 14.0], [22.58, 4.12, 30.0], [22.58, 9.32, 6.0], [22.58, 9.32, 30.0], [22.69, 29.5, 6.0], [22.69, 53.26, 6.0], [22.69, 53.26, 30.0], [27.77, 4.12, 14.0], [27.77, 53.26, 14.0], [27.77, 53.26, 30.0], [27.77, 56.26, 14.0], [30.31, 36.62, 18.0], [30.31, 53.26, 18.0], [30.31, 53.26, 30.0], [30.31, 56.26, 18.0], [32.85, 53.26, 0.0], [32.85, 53.26, 30.0], [37.5, 0.0, 6.0], [37.5, 4.12, 6.0], [37.5, 6.72, 0.0], [37.5, 6.72, 6.0], [37.5, 9.32, 6.0], [37.5, 29.5, 6.0], [42.8, 4.12, 14.0], [42.8, 4.12, 30.0], [42.8, 36.62, 18.0], [42.8, 36.62, 30.0], [45.8, 4.12, 14.0], [45.8, 36.62, 18.0], [52.8, 4.12, 6.0], [52.8, 4.12, 30.0], [57.0, -1.5, 0.0], [57.0, -1.5, 195.0]]) translate(g) sphere(r = R * 1.4, $fn = 12);
if (etichette) etichetta([0.0, 12.0, 83.25], "AS5600", 20, 0);
if (etichette) etichetta([1.73, 24.0, 33.2], "ESP32-S3", 76, 36);
if (etichette) etichetta([12.83, -6.2, 38.0], "SimpleFOC Mini", 16, 0);
if (etichette) etichetta([-10.33, 10.0, 33.5], "Mini-360", 12, -28);
if (etichette) etichetta([47.8, 1.62, 34.9], "MT3608", 14, 0);
if (etichette) etichetta([12.53, 44.37, 39.0], "Scheda servizi", 42, 0);
if (etichette) etichetta([8.6, 17.92, 4.3], "Vibrazione", 20, 0);
if (etichette) etichetta([-11.5, 1.5, 81.5], "Motore 1503", 12);
if (etichette) etichetta([0.0, 9.0, 69.0], "magnete", -12, -30);
if (etichette) etichetta([-35.0, 2.0, 18.0], "18350", 8);
if (etichette) etichetta([-56.0, 2.0, 18.0], "18350", 8);
if (etichette) etichetta([-20.0, -22.0, 0], "TP4056 ed encoder sotto la base", 6);
