PZero/Metronomus--Take-Your-Time/(list of files, cad)

Other CAD files:
modello/verifica-esp32.scad
modello/verifica-rame.scad
