PZero/Metronomus--Take-Your-Time/hardware/schema.pdf

# METRONOMUS · schema elettrico

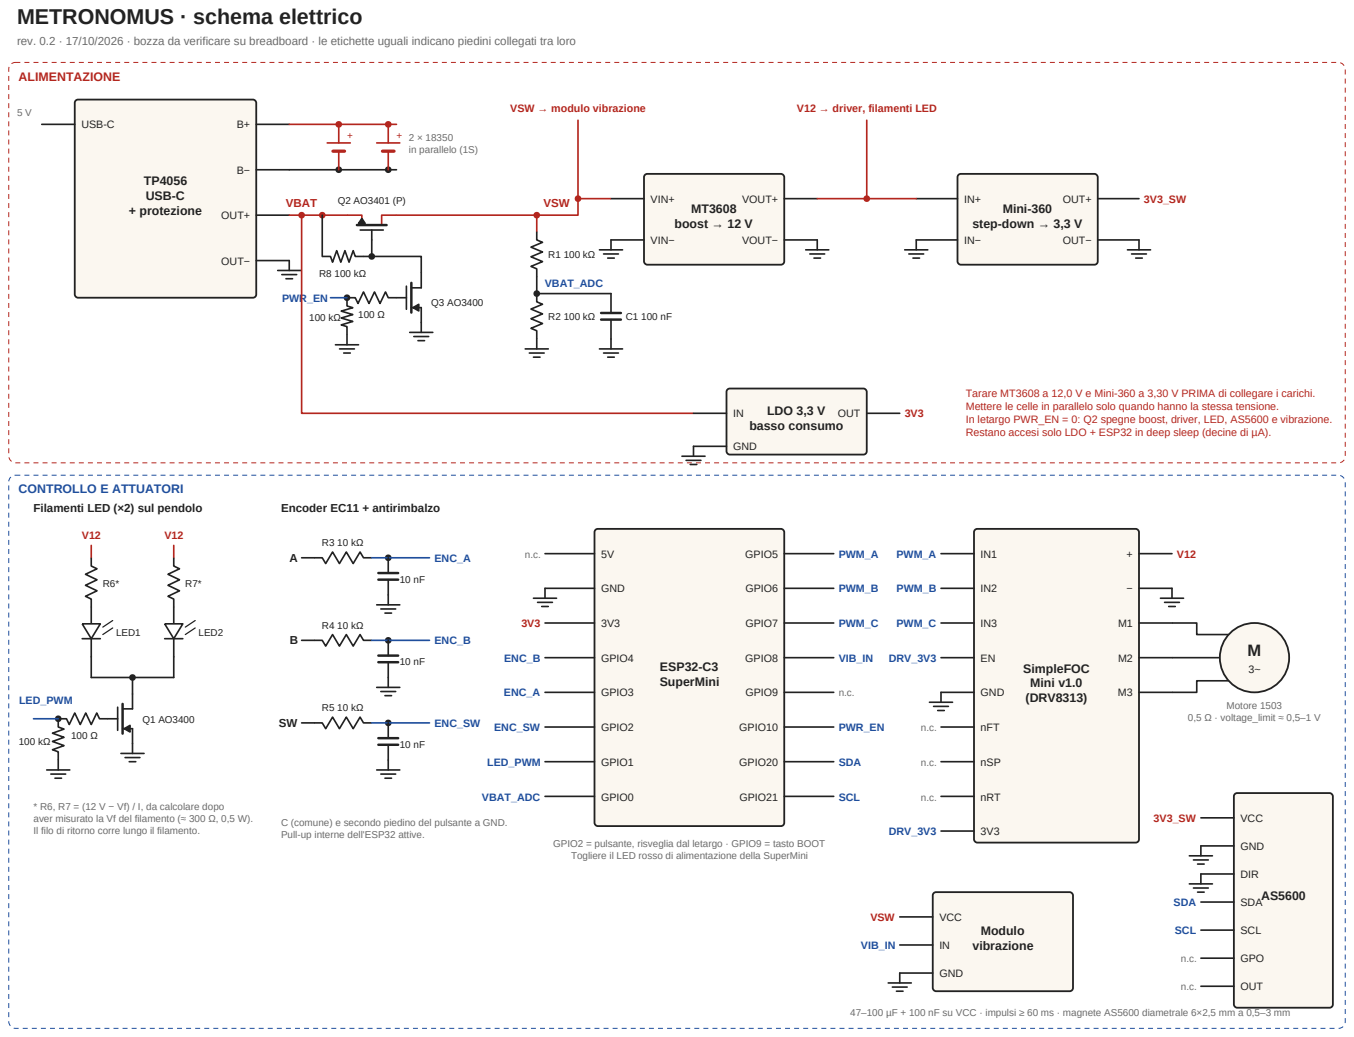
[picture p33: page 1]

rev. 0.2 · 17/10/2026 · bozza da verificare su breadboard · le etichette uguali indicano piedini collegati tra loro

Tarare MT3608 a 12,0 V e Mini-360 a 3,30 V PRIMA di collegare i carichi.
Mettere le celle in parallelo solo quando hanno la stessa tensione.
In letargo PWR_EN = 0: Q2 spegne boost, driver, LED, AS5600 e vibrazione.
Restano accesi solo LDO + ESP32 in deep sleep (decine di µA).

CONTROLLO E ATTUATORI
Filamenti LED (×2) sul pendolo

* R6, R7 = (12 V − Vf) / I, da calcolare dopo
aver misurato la Vf del filamento (≈ 300 Ω, 0,5 W).
Il filo di ritorno corre lungo il filamento.

C (comune) e secondo piedino del pulsante a GND.
Pull-up interne dell'ESP32 attive.

GPIO2 = pulsante, risveglia dal letargo · GPIO9 = tasto BOOT
Togliere il LED rosso di alimentazione della SuperMini

47–100 µF + 100 nF su VCC · impulsi ≥ 60 ms · magnete AS5600 diametrale 6×2,5 mm a 0,5–3 mm
