PZero/Metronomus--Take-Your-Time/(commit log)

2026-10-17 repo: avvia il progetto Metronomus
    Struttura cartelle, README, ruoli dei subagenti, analisi iniziale,
    roadmap, BOM provvisoria e procedura di taratura delle pieghe.
2026-10-17 elettronica: identifica il driver SimpleFOC Mini v1.0
    Driver DRV8313, motore a 8-30 V: aggiunto il vincolo di alimentazione.
2026-10-17 docs: decidi l'indicatore del tempo con il pendolo come lancetta
    Scala Maelzel incisa al laser sulla base, modalita' impostazione nel firmware.
2026-10-17 docs: riunisci le decisioni in un solo file; batteria 2S 18350 e AS5600
    - Indicatore del tempo spostato in docs/decisioni.md
    - Catena di alimentazione: 2x18350, boost 12 V, buck 3,3 V, caricatore 2S
    - Sensore AS5600 confermato
2026-10-17 elettronica: aggiungi il motore 1503 con limite di tensione FOC
2026-10-17 elettronica: usa il boost MT3608 a 12 V
2026-10-17 elettronica: usa lo step-down Mini-360 a 3,3 V
2026-10-17 elettronica: completa la lista dei componenti mancanti
2026-10-17 elettronica: identifica i componenti dalle foto e passa a batterie in parallelo
    - BOM riscritta con modelli, pinout e note per ogni modulo
    - 2x18350 in parallelo (1S) con TP4056, MT3608 a 12 V, Mini-360 dai 12 V
    - Foto dei componenti in foto/
2026-10-17 elettronica: identifica il LED come filamento LED rigido
2026-10-17 elettronica: scegli l'ESP32-C3 SuperMini e aggiungi la bozza del pinout
2026-10-17 elettronica: aggiungi motorino a vibrazione e secondo filamento LED
2026-10-17 elettronica: aggiungi motorino a vibrazione (GPIO 8) e secondo filamento LED
2026-10-17 elettronica: aggiungi lo schema elettrico e la tabella delle reti
    Schema A3 generato da hardware/schema.py (SVG, PDF, PNG).
2026-10-17 elettronica: letargo con il pulsante dell'encoder al posto dell'interruttore
    - LDO sempre acceso per l'ESP32, MOSFET AO3401/AO3400 sulla parte di potenza
    - Pulsante su GPIO2 (risveglio dal deep sleep), PWR_EN su GPIO10
    - Schema rev. 0.2, teca di vetro tra le decisioni
    - Primo render di concept
2026-10-17 render con la teca di vetro, tic con il motorino, niente portapile
    Claude-Session: https://claude.ai/code/session_012hZ28BsEx1VPZxNsqZvSKY
2026-10-17 modello 3D di controllo in OpenSCAD
    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
    [metronomus.scad]
2026-10-17 rame: disposizione compatta dalle misure dei moduli, controlli e distinta
    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
    [metronomus.scad, segmenti.csv]
2026-10-18 elettronica: la scheda è un'ESP32-S3 SuperMini, non una C3
    - moduli.yaml: misure dal disegno quotato Nologo (23,50 x 18,00, 2 file da 9 pin);
    TP4056 dalla foto quotata del venditore (26,1 x 17,4)
    - nuovo pinout (PWM 6/5/4, I2C 1/2, PWR_EN 7, vibrazione 3, encoder 12/13/11,
    LED 10, ADC 9), schema rev. 0.2.1 (solo SVG), BOM e foto rinominata
    - rame: S3 ruotata di 90 gradi, scheda servizi riordinata; 84 pezzi, 2,67 m,
    controlli superati
    [metronomus.scad, segmenti.csv]
2026-10-18 rame: SimpleFOC Mini dal disegno quotato, driver spostato di un passo
    - moduli.yaml: SimpleFOC Mini 26 x 21,5, fori Ø2 a 22 x 17,5, pin dal disegno
    - con le misure vere il driver toccava il Mini-360: PWM su GPIO7/6/5,
    PWR_EN su GPIO4, pulsante dell'encoder su GPIO8 (pinout e schema aggiornati)
    - geometria: 84 pezzi, 2,67 m, controlli superati
    [metronomus.scad, segmenti.csv]
2026-10-18 geometria: controllo delle schede che si sovrappongono
    Confronta gli ingombri dei moduli tra loro e con motore, batterie e
    pannello, con un gioco di 0,5 mm. Avrebbe trovato il contatto tra
    SimpleFOC Mini e Mini-360; oggi segnala l'AS5600 a 0,2 mm dal motore
    (il magnete non è ancora nel modello): annotato in STATO e nelle misure.
2026-10-18 modello: criticità in rosso e magnete dell'AS5600
    - geometria.py registra pezzi, schede e ostacoli coinvolti negli errori;
    lo script OpenSCAD li colora di rosso, evidenzia le zone di contatto e
    stampa l'elenco in console (interruttore `criticita`)
    - aggiunto il magnete Ø6 x 2,5 sull'albero, come ostacolo e nel modello
    - anteprima in modello/criticita.png
    [metronomus.scad]
2026-10-18 modello: etichette con i nomi di schede e componenti
    [metronomus.scad]
2026-10-18 fine sessione 18/10: ESP32-S3, misure dai disegni quotati, criticità nel modello
    - la scheda è un'ESP32-S3: misure Nologo, nuovo pinout e schema rev. 0.2.1
    - SimpleFOC Mini e TP4056 dai disegni quotati; driver spostato di un passo
    - controllo delle sovrapposizioni, magnete dell'AS5600, criticità ed
    etichette nello script OpenSCAD; modello adatto a ogni ruolo
    - STATO riscritto, nuove domande aperte; resta l'AS5600 troppo vicino al motore
2026-10-18 rame a bus: discese per scheda e bus sollevati con gioco di montaggio
    - geometria.py diviso in bus (massa 6 mm, 12 V 14 mm, segnali 18 mm)
    che sporgono 3 mm oltre l'ultima discesa, e discese scheda per scheda
    - segmenti.csv in ordine di montaggio (colonna gruppo)
    - decisioni: circuito a bus, AS5600 diretto, LED con filo flessibile
    - domande aperte: stop di emergenza, masse separate
    [metronomus.scad, segmenti.csv]
2026-10-18 stop di emergenza: finecorsa in rame e contatto che spegne il driver
    - paletti di rame a ±45° nel piano del pendolo (rete STOP): finecorsa
    meccanici, collegati all'EN del driver (R9 10 kΩ al posto del
    ponticello) e a GPIO43
    - collare di ottone sul pendolo (rete ARMA, GPIO44, filo flessibile):
    con ARMA = 0 il contatto spegne il driver in hardware, ARMA = 1 solo
    all'avvio per staccarsi dal finecorsa su cui il pendolo cade in letargo
    - schema rev. 0.2.2 (SVG), pinout, BOM, decisioni, domande aperte
    - rame: 93 pezzi, 3,19 m; fili flessibili calcolati (30-36 mm)
    [metronomus.scad, segmenti.csv]
2026-10-18 risposte di Fabio: base 150 mm, magnete a filo, driver v1.0, masse
    - base 150 x 90 mm e nuovo controllo: tutto dentro la teca
    - magnete da 2 mm a filo del motore, AS5600 arretrato: risolti i
    contatti con motore e magnete (ESP32 e Mini-360 restano fermi)
    - SimpleFOC v1.0: serigrafia confermata (la v1.1 ha la fila IN invertita)
    - masse non separate (ruolo elettronica): foro del ritorno batteria
    tra MT3608 e driver, condensatori su driver e AS5600
    - domande 7-18 chiuse o rimandate; nuova 19 sul pannello della scala
    [metronomus.scad, segmenti.csv]
2026-10-18 scala su ±30°: pannello ricavato dall'arco, tutto nella base da 150 mm
    - ARCO_SCALA = 30° in geometria.py: pannello (124 mm), colonne,
    tacche del modello e finecorsa (±35°, paletti 94,5 mm) ne derivano
    - geometria senza errori: 93 pezzi, 3,16 m
    - documenti e schema aggiornati da ±45° a ±35°
    [metronomus.scad, segmenti.csv]
2026-10-18 fine sessione 18/10: rame a bus, stop di emergenza, base 150 mm, scala ±30°
    - STATO riscritto: geometria senza errori (93 pezzi, 3,16 m), moduli
    ancora su misure stimate, prossimi passi e attese da Fabio
    - risposte di Fabio registrate, masse non separate, ponticello EN
    sostituito da R9 (stop di emergenza)
2026-10-18 2N3904 del kit per Q1 e Q3, PDF 1:1 e verifiche OpenSCAD
    - Q1 (LED) e Q3 (comando del letargo) diventano 2N3904 NPN TO-92 già
    in casa al posto degli AO3400: millefori ridisposta (netlist
    controllata), schema con simbolo NPN, pinout, BOM, decisioni.
    Q2 resta AO3401.
    - Inclusi i lavori della sera: misure col calibro, PDF 1:1 del rame,
    scheda servizi su millefori, verifiche OpenSCAD per gradi.
    [metronomus.scad, segmenti.csv, verifica-alimentazione.scad, verifica-esp32.scad, verifica-rame.scad]
